roeetal/enph253/Software/Edges/img.jpg

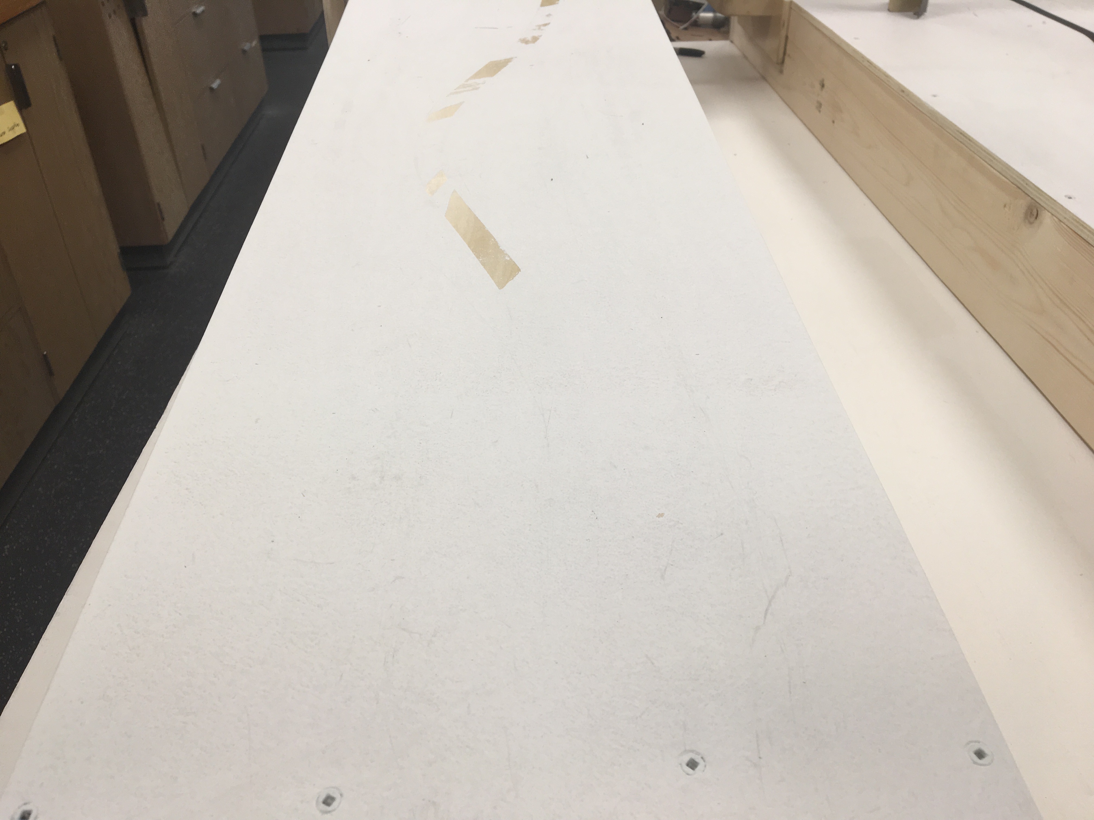
Software/Edges/img.jpg
