roeetal/enph253/Software/STM32/Generic/sonar.JPG

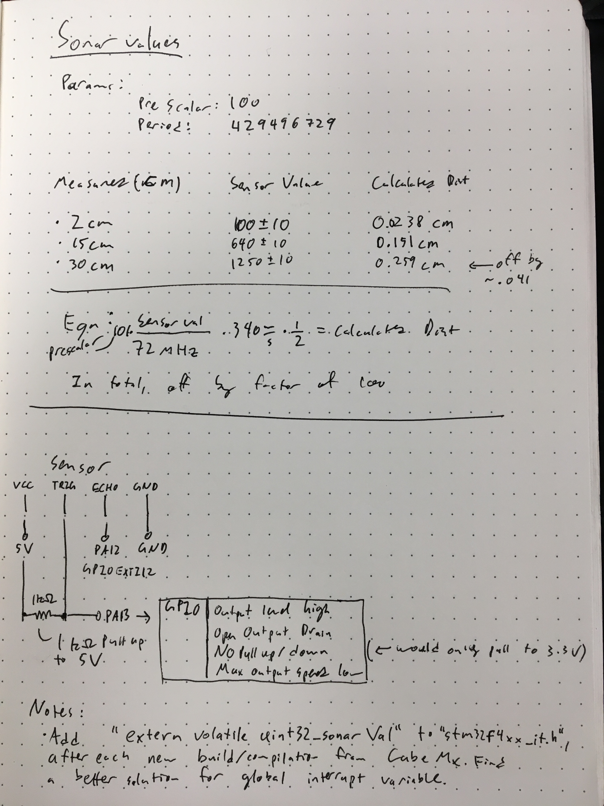
Software/STM32/Generic/sonar.JPG
