roeetal/enph253/README.md

# enph253
## Robot competition

### Links
* Main source-code folder: https://github.com/roeetal/enph253/tree/master/Software/STM32/brain
* Google Slides for technical presentation: 
  https://docs.google.com/presentation/d/15P2V7RuZFssEo_z1w1n5baqb6ON2kBNIlDU9cCNbAWw/edit?usp=sharing
* Report / website:
https://axel-jacobsen.github.io/ENPHRobot/
