roeetal/enph253/Electrical/README.md

# Electrical

## Libraries

Create individual components that you cannot find or import from somewhere else.

## Design Blocks

Multiple compoenents connected together to form a single module, or design block. These get imported into the schematic.
