roeetal/enph253/Presentation/README.md

Software Flowchart Link: https://www.lucidchart.com/documents/edit/5ae4b252-0b9d-4778-aa35-208c34e453aa/0
Major Block Diagram Link: https://www.draw.io

Note: these are both under my account, so this is more for me (axel)
