roeetal/enph253/Software/STM32/adc_dma/Readme.md

https://www.carminenoviello.com/2015/03/02/how-to-use-stm32-nucleo-serial-port/

https://controllerstech.com/adc-using-dma-direct-memory-access/
