roeetal/enph253/Software/STM32/Wiskers/README.md

# Wiskeyyys

- Works well, accurate enough within 22 cm from edge (with a height of 12 cm).
