roeetal/enph253/links.md

## Good Solder Connections
https://www.youtube.com/watch?v=O-ymw7d_nYo

## Cheap Tank Tracks
http://www.instructables.com/id/How-to-make-custom-and-strong-tank-tracks-for-very/
