roeetal/enph253/design_calculations.xlsx

Sheet: Arm
Legend
Good Output
Error Output
Input (Parameters we change)
Calculated Value (Do not touch)
Inputs |  |  | Outputs
Arm Length | 0.2 | m | Can Lift | TRUE
COM | 0.18 | m (from pivot) | FOS | 18.56
Chewie Mass | 0.07 | kg
Mass of Arm | 0.018 | kg
Factor of Safety | 3
Stall torque | 0.32 | N*m

Sheet: DriveTrain
Legend
Good Output
Error Output
Input (Parameters we change)
Calculated Value (Do not touch)
Inputs |  |  | Outputs
Robot Mass | 5.26 | kg | Can Climb Gap | TRUE
Rear Track Length | 0.25 | m | Can Climb Ramp | TRUE
Front Track Length | 0.18 | m
Front Track Rise | 0.076 | m
Gx (measured from rear) | 0.23 | m
Gy (measured from ground) | 0.09 | m
Motor Stall Torque | 0.037 | Nm
Number of motors | 4
Gear Ratio | 25
Factor of Safety | 1
Wheel Radius | 0.0635 | m

Sheet: Basket
Legend
Good Output
Error Output
Input (Parameters we change)
Calculated Value (Do not touch)
Inputs |  |  | Outputs
Arm Length | 0.127 | m | Can Lift | TRUE
Ewok Mass | 0.04 | kg
Chewie Mass | 0.07 | kg
Basket Mass | 0.106 | kg
Servo Stall Torque | 0.4 | Nm
Arm Mass | 0.013 | kg
Factor of Safety | 1.5
