roeetal/enph253/Presentation/b2.png

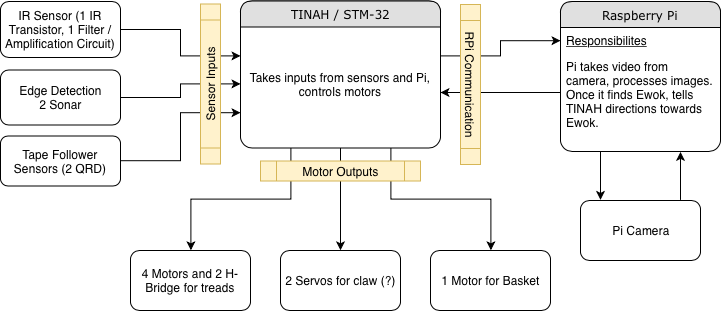
Presentation/b2.png
