roeetal/enph253/Presentation/Software Diagram Transparent Background.png

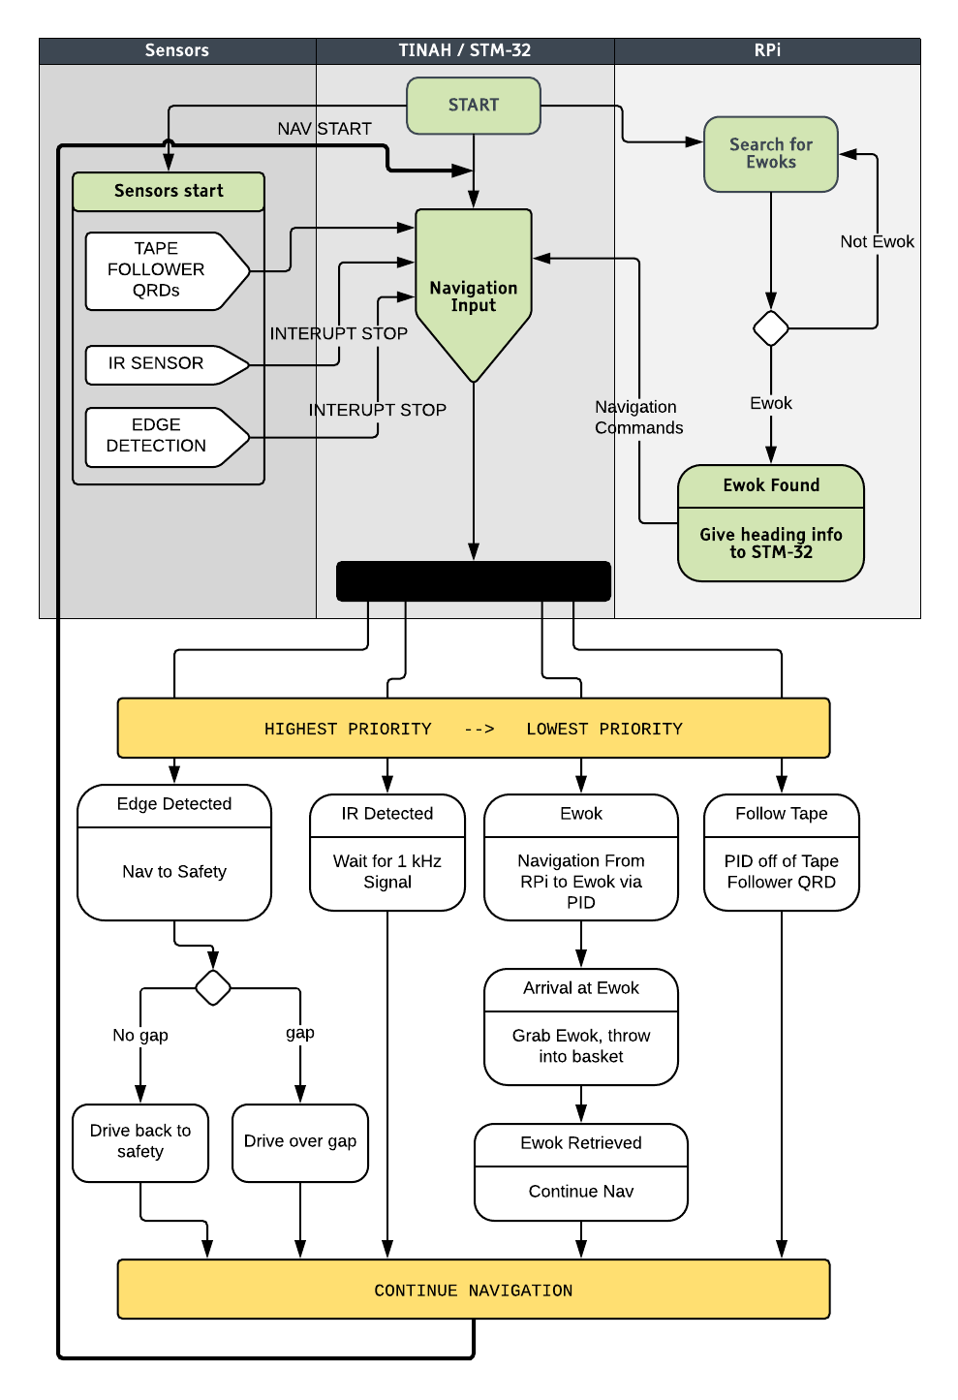
Presentation/Software Diagram Transparent Background.png
