roeetal/enph253/Mechanical/parts.md

# Mechanical Parts

- Chassis
- Arm
- Basket

## Chassis

- Plexiglas or aluminium frame
- Wheels, axles, bearing, motors
- Mounts for other components

## Arm

- Axle, bearings, motor
- Arm frame
- Grabber
- Contact Sensor
- IR sensor

## Basket

- Basket
- Lifting guide/railing
- Motor

## Controls

- TINAH board
- IR sensors
- Sonar Sensors
- Various electronic modules
