roeetal/enph253/Electrical/modules/pcb/board.brd

## EAGLE design Electrical/modules/pcb/board.brd (2018-07-20)

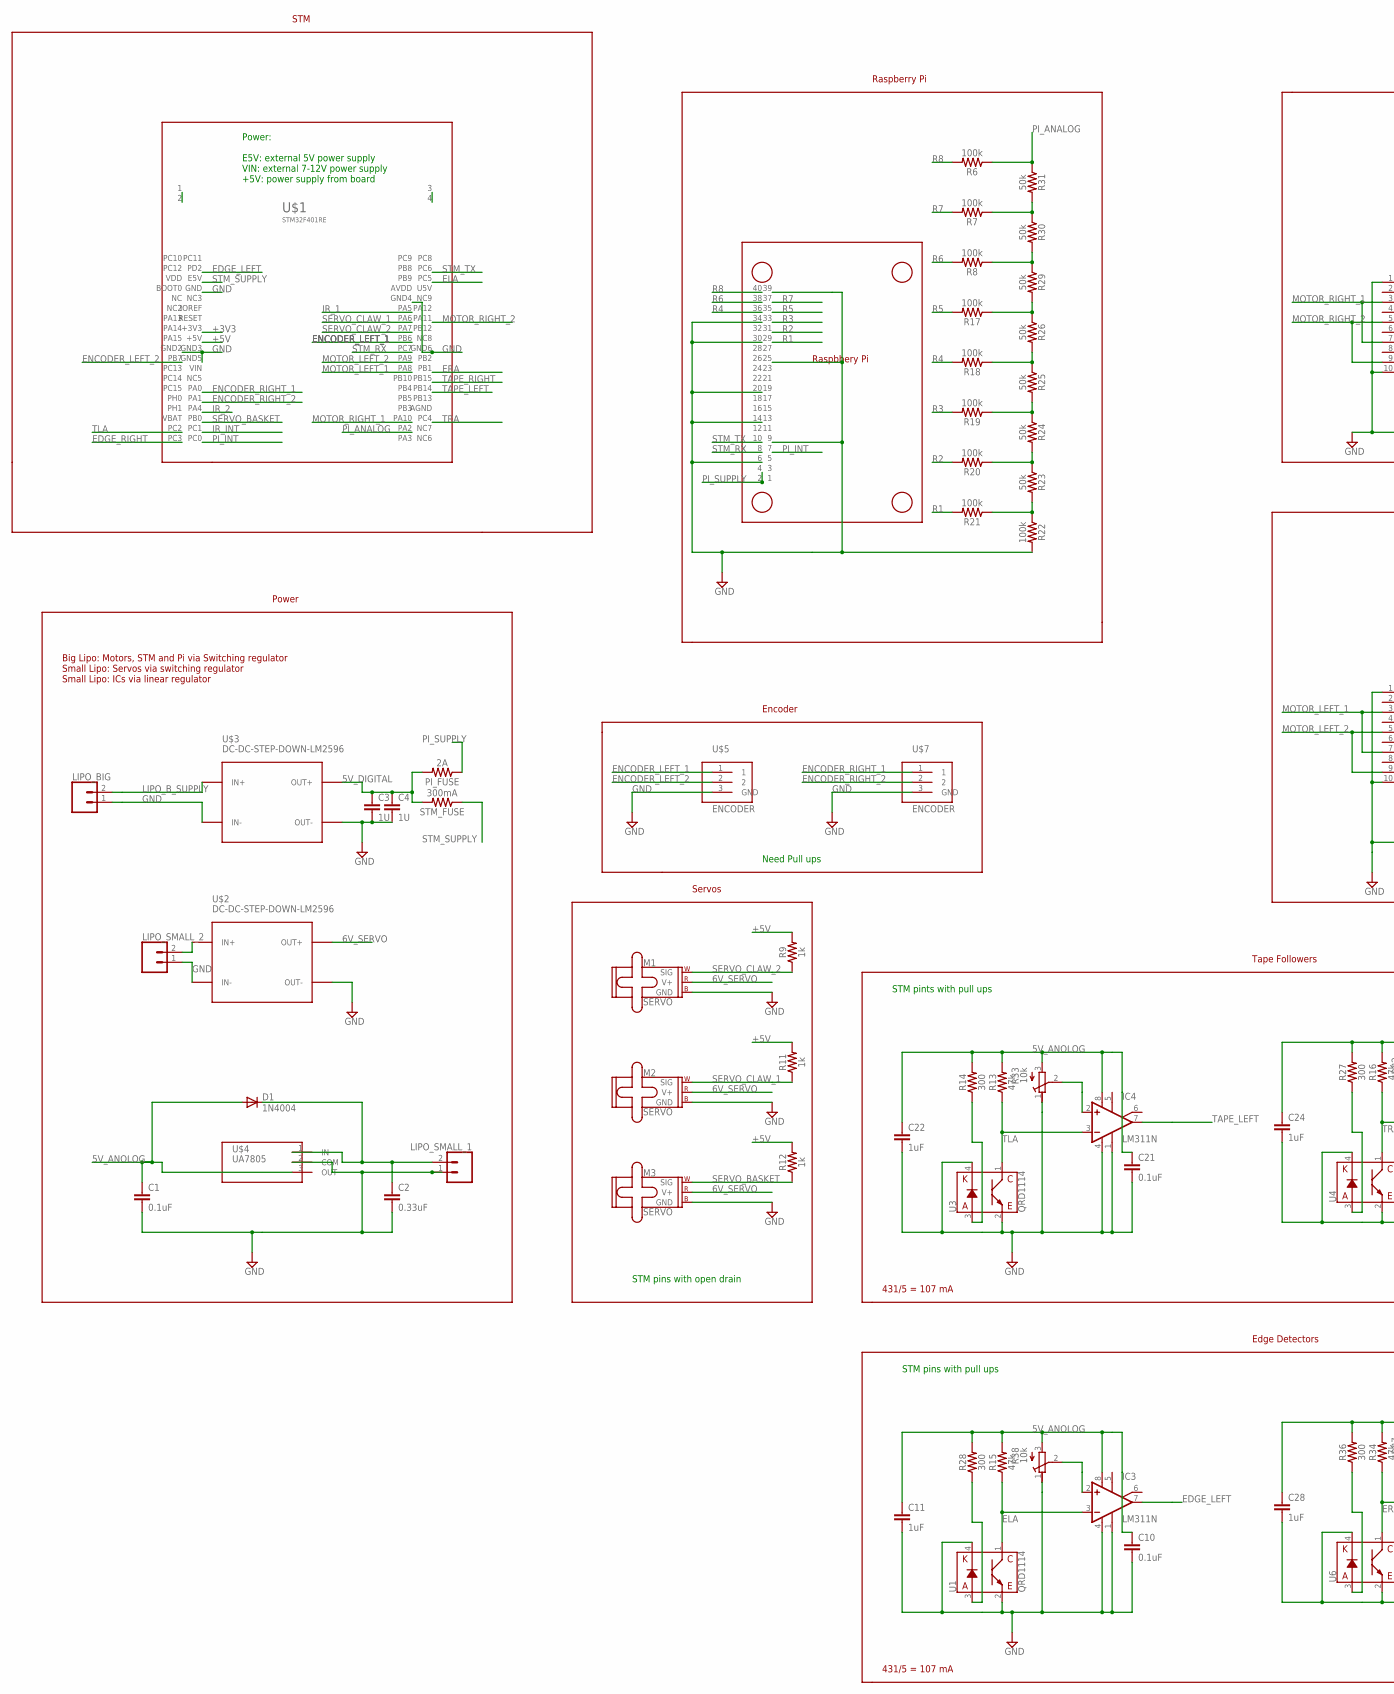
[picture p5: schematic board.sch, part in row 1, column 1]

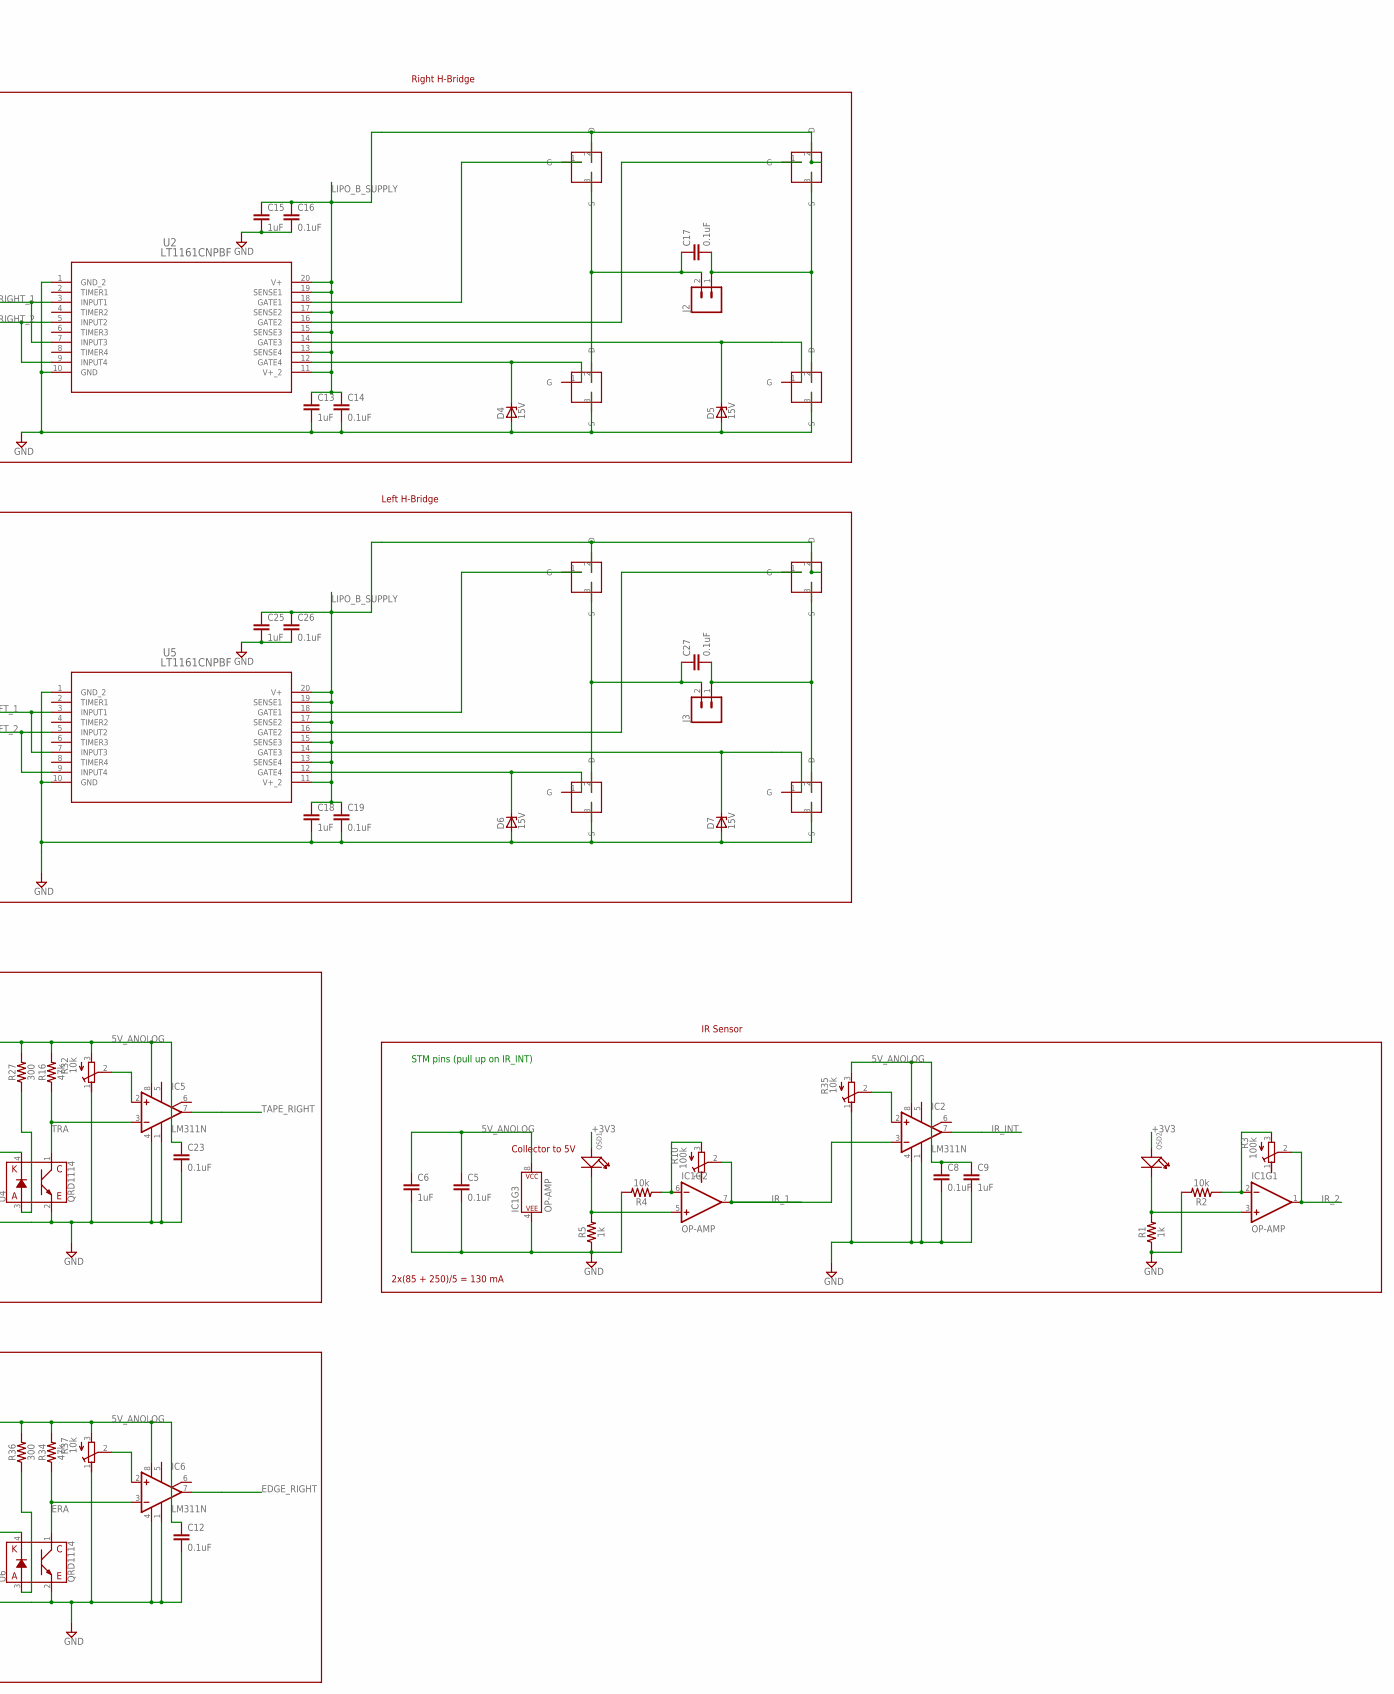
[picture p6: schematic board.sch, part in row 1, column 2]

Parts:
C1, C5, C8, C10, C12, C14, C16, C17, C19, C21, C23, C26, C27: 0.1uF; CAP-PTH-SMALL-KIT
C2: 0.33uF; CAP-PTH-SMALL-KIT
C3, C4: 1U; C5B5
C6, C9, C11, C13, C15, C18, C22, C24, C25, C28: 1uF; CAP-PTH-SMALL-KIT
D1: 1N4004; DO41-10
D4, D5, D6, D7: 15V; DO41Z10
IC1: OP-AMP; DIP08
IC2, IC3, IC4, IC5, IC6: LM311N; DIL08
J2, J3: CONN_02; 1X02
LIPO_BIG: CONN_02; 1X02
LIPO_SMALL_1, LIPO_SMALL_2: CONN_02; 1X02
M1, M2, M3: SERVO; 1X03
PI_FUSE: 2A; AXIAL-0.3
QSD1, QSD2: DIP-LED-GREEN-GREEN(2P-D5MM); LED2-2.54-D5.0MM
R1, R5, R9, R11, R12: 1k; AXIAL-0.3
R2, R4: 10k; AXIAL-0.3
R3, R10: 100k; RTRIMT93YA
R6, R7, R8, R17, R18, R19, R20, R21, R22: 100k; AXIAL-0.3
R13, R15, R16, R34: 47k; AXIAL-0.3
R14, R27, R28, R36: 300; AXIAL-0.3
R23, R24, R25, R26, R29, R30, R31: 50k; AXIAL-0.3
R32, R33, R35, R37, R38: 10k; RTRIMT93YA
STM_FUSE: 300mA; AXIAL-0.3
U1, U3, U4, U6: QRD1114
U2, U5: LT1161CNPBF; PDIP-20_N
U$1: STM32F401RE; STM32
U$2, U$3: DC-DC-STEP-DOWN-LM2596
U$4: UA7805; TO-220AB
U$5, U$7: ENCODER; TO-220AB
U$6: RPI3; PI
U$11, U$12, U$13, U$14, U$15, U$16, U$17, U$18: HUF75321; TO-220AB

Connections:
5V_ANOLOG: C1.1, C5.1, C6.1, C8.1, C9.1, C10.1, C11.1, C12.1, C21.1, C22.1, C23.1, C24.1, C28.1, D1.A, IC1.8 (P$V+), IC2.8 (V+), IC3.8 (V+), IC4.8 (V+), IC5.8 (V+), IC6.8 (V+), R13.P$2 (2), R14.P$2 (2), R15.P$2 (2), R16.P$2 (2), R27.P$2 (2), R28.P$2 (2), R32.3 (A), R33.3 (A), R34.P$2 (2), R35.3 (A), R36.P$2 (2), R37.3 (A), R38.3 (A), U$4.3 (OUT)
5V_DIGITAL: C3.1, C4.1, PI_FUSE.P$2 (2), STM_FUSE.P$2 (2), U$3.OUT+
6V_SERVO: M1.2 (V+), M2.2 (V+), M3.2 (V+), U$2.OUT+
+3V3: QSD1.+, QSD2.+, U$1.+3V3
+5V: R9.P$2 (2), R11.P$2 (2), R12.P$2 (2), U$1.+5V
EDGE_LEFT: IC3.7 (OUT), U$1.PD2
EDGE_RIGHT: IC6.7 (OUT), U$1.PC3
ELA: IC3.3 (-IN), R15.P$1 (1), U1.1 (C), U$1.PC5
ENCODER_LEFT_1: U$1.PB6, U$5.1
ENCODER_LEFT_2: U$1.PB7, U$5.2
ENCODER_RIGHT_1: U$1.PA0, U$7.1
ENCODER_RIGHT_2: U$1.PA1, U$7.2
ERA: IC6.3 (-IN), R34.P$1 (1), U6.1 (C), U$1.PB1
GND: C1.2, C2.2, C3.2, C4.2, C5.2, C6.2, C8.2, C9.2, C10.2, C11.2, C12.2, C13.2, C14.2, C15.2, C16.2, C18.2, C19.2, C21.2, C22.2, C23.2, C24.2, C25.2, C26.2, C28.2, D4.A, D5.A, D6.A, D7.A, IC1.4 (P$V-), IC2.1 (GND), IC2.4 (V-), IC3.1 (GND), IC3.4 (V-), IC4.1 (GND), IC4.4 (V-), IC5.1 (GND), IC5.4 (V-), IC6.1 (GND), IC6.4 (V-), LIPO_BIG.1, LIPO_SMALL_1.1, LIPO_SMALL_2.1, M1.3 (GND), M2.3 (GND), M3.3 (GND), R1.P$1 (1), R2.P$2 (2), R4.P$2 (2), R5.P$1 (1), R22.P$2 (2), R32.1 (E), R33.1 (E), R35.1 (E), R37.1 (E), R38.1 (E), U1.2 (E), U1.4 (K), U2.1 (GND_2), U2.10 (GND), U3.2 (E), U3.4 (K), U4.2 (E), U4.4 (K), U5.1 (GND_2), U5.10 (GND), U6.2 (E), U6.4 (K), U$1.GND, U$1.GND2, U$1.GND3, U$1.GND4, U$1.GND5, U$1.GND6, U$2.IN-, U$2.OUT-, U$3.IN-, U$3.OUT-, U$4.2 (COM), U$5.3 (GND), U$6.6, U$6.9, U$6.14, U$6.20, U$6.25, U$6.30, U$6.34, U$6.39, U$7.3 (GND), U$13.3 (S), U$14.3 (S), U$17.3 (S), U$18.3 (S)
IR_1: IC1.7 (OUT), IC2.3 (-IN), R10.2 (S), U$1.PA5
IR_2: IC1.1 (OUT), R3.2 (S), U$1.PA4
IR_INT: IC2.7 (OUT), U$1.PC1
LIPO_B_SUPPLY: C13.1, C14.1, C15.1, C16.1, C18.1, C19.1, C25.1, C26.1, LIPO_BIG.2, U2.11 (V+_2), U2.13 (SENSE4), U2.15 (SENSE3), U2.17 (SENSE2), U2.19 (SENSE1), U2.20 (V+), U5.11 (V+_2), U5.13 (SENSE4), U5.15 (SENSE3), U5.17 (SENSE2), U5.19 (SENSE1), U5.20 (V+), U$3.IN+, U$11.2 (D), U$12.2 (D), U$15.2 (D), U$16.2 (D)
MOTOR_LEFT_1: U5.3 (INPUT1), U5.7 (INPUT3), U$1.PA8
MOTOR_LEFT_2: U5.5 (INPUT2), U5.9 (INPUT4), U$1.PA9
MOTOR_RIGHT_1: U2.3 (INPUT1), U2.7 (INPUT3), U$1.PA10
MOTOR_RIGHT_2: U2.5 (INPUT2), U2.9 (INPUT4), U$1.PA11
unnamed: LIPO_SMALL_2.2, U$2.IN+
unnamed: IC1.2 (-IN), R2.P$1 (1), R3.3 (A)
unnamed: R28.P$1 (1), U1.3 (A)
unnamed: IC1.6 (-IN), R4.P$1 (1), R10.3 (A)
unnamed: R21.P$1 (1), R22.P$1 (1), R23.P$2 (2)
unnamed: IC5.2 (+IN), R32.2 (S)
unnamed: R20.P$1 (1), R23.P$1 (1), R24.P$2 (2)
unnamed: R19.P$1 (1), R24.P$1 (1), R25.P$2 (2)
unnamed: R18.P$1 (1), R25.P$1 (1), R26.P$2 (2)
unnamed: R17.P$1 (1), R26.P$1 (1), R29.P$2 (2)
unnamed: R8.P$1 (1), R29.P$1 (1), R30.P$2 (2)
unnamed: R7.P$1 (1), R30.P$1 (1), R31.P$2 (2)
unnamed: IC2.2 (+IN), R35.2 (S)
unnamed: IC3.2 (+IN), R38.2 (S)
unnamed: R14.P$1 (1), U3.3 (A)
unnamed: R36.P$1 (1), U6.3 (A)
unnamed: IC6.2 (+IN), R37.2 (S)
unnamed: U2.18 (GATE1), U$11.1 (G)
unnamed: U2.16 (GATE2), U$12.1 (G)
unnamed: D5.C, U2.14 (GATE3), U$14.1 (G)
unnamed: D4.C, U2.12 (GATE4), U$13.1 (G)
unnamed: C17.2, J2.1, U$12.3 (S), U$14.2 (D)
unnamed: C17.1, J2.2, U$11.3 (S), U$13.2 (D)
unnamed: U5.18 (GATE1), U$15.1 (G)
unnamed: U5.16 (GATE2), U$16.1 (G)
unnamed: IC4.2 (+IN), R33.2 (S)
unnamed: R27.P$1 (1), U4.3 (A)
unnamed: U$1.1, U$1.2
unnamed: D7.C, U5.14 (GATE3), U$18.1 (G)
unnamed: D6.C, U5.12 (GATE4), U$17.1 (G)
unnamed: C27.2, J3.1, U$16.3 (S), U$18.2 (D)
unnamed: C27.1, J3.2, U$15.3 (S), U$17.2 (D)
unnamed: U$1.3, U$1.4
OUTPUT1: IC1.5 (+IN), QSD1.-, R5.P$2 (2)
OUTPUT2: IC1.3 (+IN), QSD2.-, R1.P$2 (2)
PI_ANALOG: R6.P$1 (1), R31.P$1 (1), U$1.PA2
PI_INT: U$1.PC0, U$6.7
PI_SUPPLY: PI_FUSE.P$1 (1), U$6.2, U$6.4
R1: R21.P$2 (2), U$6.29
R2: R20.P$2 (2), U$6.31
R3: R19.P$2 (2), U$6.33
R4: R18.P$2 (2), U$6.36
R5: R17.P$2 (2), U$6.35
R6: R8.P$2 (2), U$6.38
R7: R7.P$2 (2), U$6.37
R8: R6.P$2 (2), U$6.40
SERVO_BASKET: M3.1 (SIG), R12.P$1 (1), U$1.PB0
SERVO_CLAW_1: M2.1 (SIG), R11.P$1 (1), U$1.PA6
SERVO_CLAW_2: M1.1 (SIG), R9.P$1 (1), U$1.PA7
STM_RX: U$1.PC7, U$6.8
STM_SUPPLY: STM_FUSE.P$1 (1), U$1.E5V
STM_TX: U$1.PC6, U$6.10
TAPE_LEFT: IC4.7 (OUT), U$1.PB14
TAPE_RIGHT: IC5.7 (OUT), U$1.PB15
TLA: IC4.3 (-IN), R13.P$1 (1), U3.1 (C), U$1.PC2
TRA: IC5.3 (-IN), R16.P$1 (1), U4.1 (C), U$1.PC4
V_IN1: C2.1, D1.C, LIPO_SMALL_1.2, U$4.1 (IN)

Notes on the sheet:
Power: E5V: external 5V power supply VIN: external 7-12V power supply +5V: power supply from board
Collector to 5V
STM pins (pull up on IR_INT)
STM pints with pull ups
Tape Followers
IR Sensor
2x(85 + 250)/5 = 130 mA
431/5 = 107 mA
Big Lipo: Motors, STM and Pi via Switching regulator Small Lipo: Servos via switching regulator Small Lipo: ICs via linear regulator
Power
STM
Servos
STM pins with open drain
Left H-Bridge
Right H-Bridge
Encoder
Raspberry Pi
STM pins with pull ups
Edge Detectors
Need Pull ups

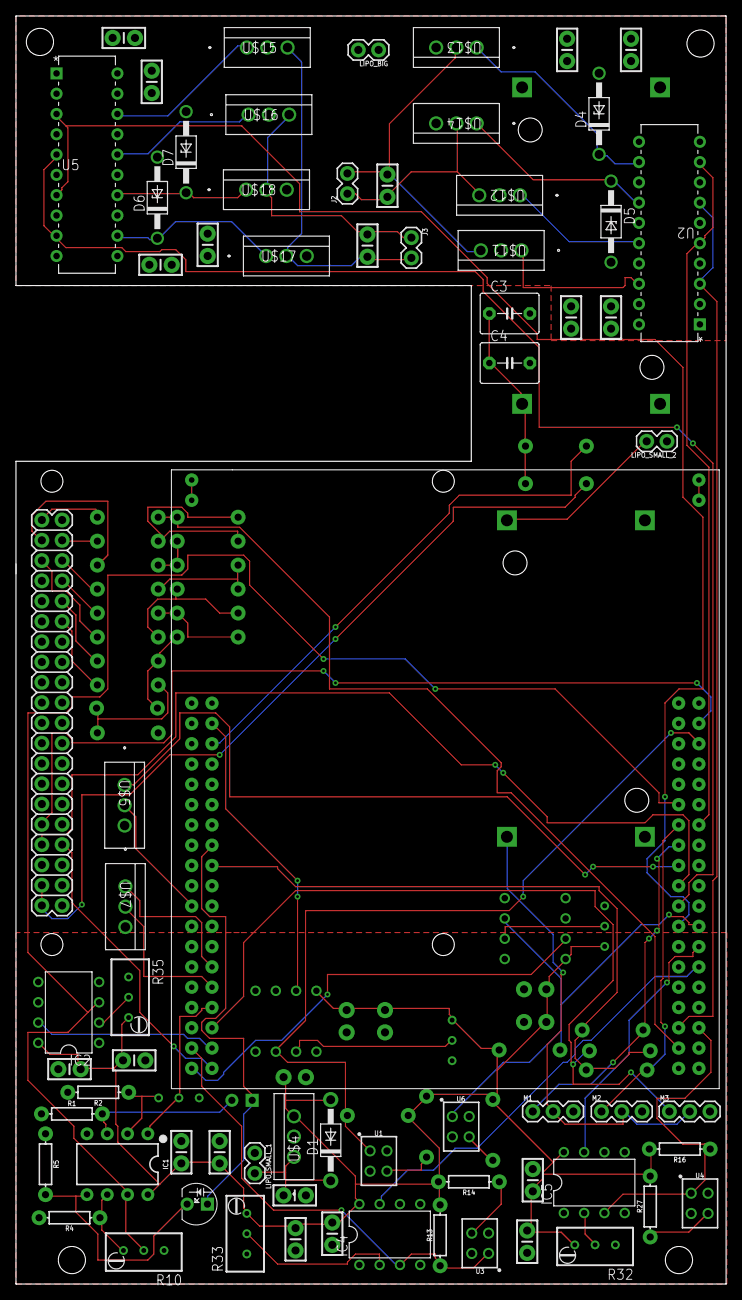
[picture p7: board board.brd from above]

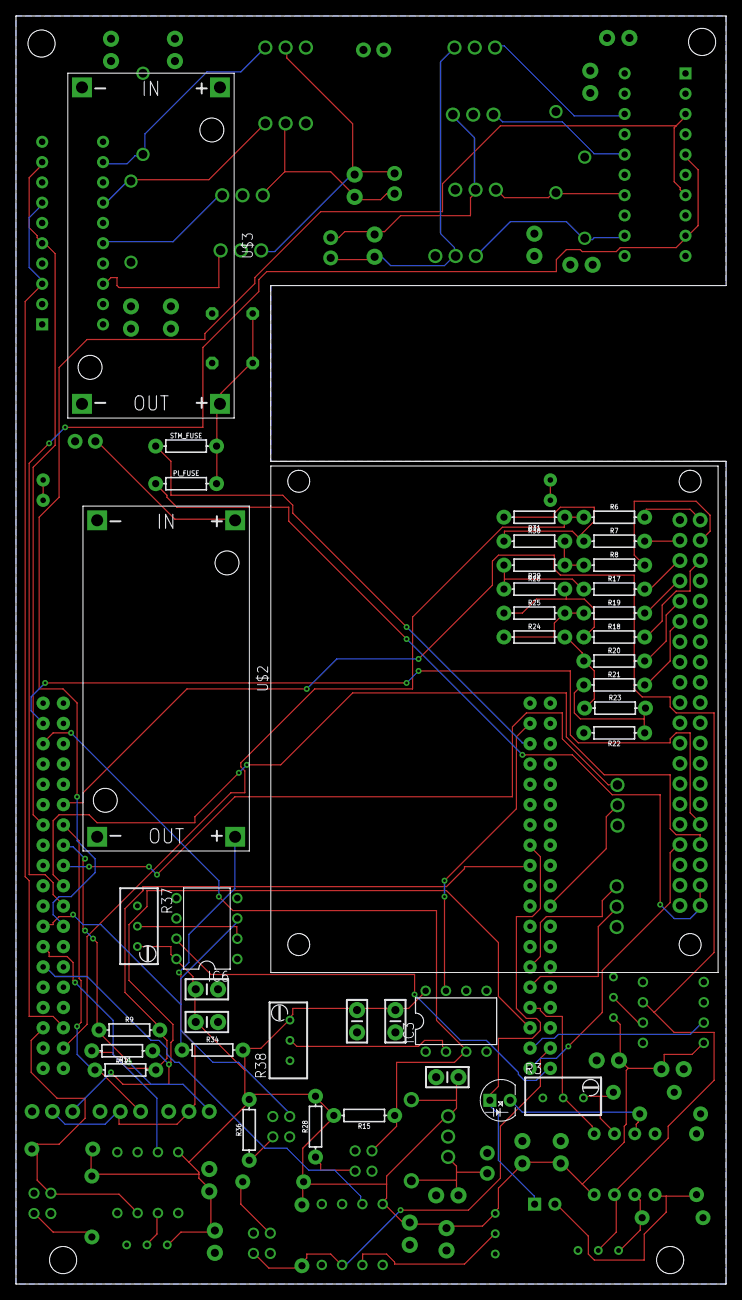
[picture p8: board board.brd from below]

Board: 2 copper layers, 88.9 x 158.8 mm, 108 parts (38 on the bottom side), 79 nets.
