roeetal/enph253/Software/STM32/thikc/Src/main.c

/**
 ******************************************************************************
 * @file           : main.c
 * @brief          : Main program body
 ******************************************************************************
 ** This notice applies to any and all portions of this file
 * that are not between comment pairs USER CODE BEGIN and
 * USER CODE END. Other portions of this file, whether 
 * inserted by the user or by software development tools
 * are owned by their respective copyright owners.
 *
 * COPYRIGHT(c) 2018 STMicroelectronics
 *
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
 ******************************************************************************
 */
/* Includes ------------------------------------------------------------------*/
#include "main.h"
#include "stm32f1xx_hal.h"
#include "adc.h"
#include "dma.h"
#include "i2c.h"
#include "tim.h"
#include "usart.h"
#include "gpio.h"

/* USER CODE BEGIN Includes */
#include "fonts.h"
#include "ssd1306.h"
#include "encoder.h"
#include "pid.h"
#include "filter.h"
#include "extern_vars.h"
#include <String.h>
#include "claw.h"

/* USER CODE END Includes */


/* USER CODE BEGIN PV */
uint16_t LEFT_SPEED = 40000;
uint16_t RIGHT_SPEED = 45000;
uint32_t dma_buffer[2048];
uint32_t ir_values[2048];
/* USER CODE END PV */

void SystemClock_Config(void);

/* USER CODE BEGIN PFP */
void print(char msg[], int row);
void do_pid(PID_t *pid_struct);
PID_t menu();
void frequency_comparison(uint16_t freq1, uint16_t freq2, uint16_t GPIO_Pin);
void pi_navigation();
float calculate_heading(uint32_t adc_val);
void encoder_pid(PID_t *left_pid, ENCODER_t *left_enc, PID_t *right_pid, ENCODER_t *right_enc);
void set_motor_speed(uint32_t channel, uint32_t speed);
void turn();
void turn_deg(uint8_t);
void alarm_detect();

/* USER CODE END PFP */

/* USER CODE BEGIN 0 */
/**
 * @brief Circu;ar DMA buffer loading on each full buffer
 * DMA uses dma_buffer, transfers data to ir_values for us to use
 * Order of buffer: ir1, ir2, ir1, ir2...
 */
void HAL_ADC_ConvCpltCallback(ADC_HandleTypeDef *hadc)
{
    memcpy(ir_values, dma_buffer, sizeof(dma_buffer));
}

/* USER CODE END 0 */

/**
 * @brief  The application entry point.
 *
 * @retval None
 */
int main(void)
{
    /* MCU Configuration----------------------------------------------------------*/

    /* Reset of all peripherals, Initializes the Flash interface and the Systick. */
    HAL_Init();

    /* Configure the system clock */
    SystemClock_Config();

    /* Initialize all configured peripherals */
    MX_GPIO_Init();
    MX_DMA_Init();
    MX_TIM4_Init();
    MX_TIM3_Init();
    MX_TIM1_Init();
    MX_ADC1_Init();
    MX_TIM2_Init();
    MX_USART2_UART_Init();
    MX_ADC2_Init();
    MX_I2C1_Init();
    /* USER CODE BEGIN 2 */

    /* Initialize peripherals */
    HAL_TIM_Encoder_Start(&htim3, TIM_CHANNEL_ALL);
    HAL_TIM_Encoder_Start(&htim4, TIM_CHANNEL_ALL);
    HAL_TIM_PWM_Start(&htim1, TIM_CHANNEL_1);
    HAL_TIM_PWM_Start(&htim1, TIM_CHANNEL_2);
    HAL_TIM_PWM_Start(&htim1, TIM_CHANNEL_3);
    HAL_TIM_PWM_Start(&htim1, TIM_CHANNEL_4);
    HAL_TIM_PWM_Start(&htim2, TIM_CHANNEL_1);
    HAL_TIM_PWM_Start(&htim2, TIM_CHANNEL_2);
    HAL_TIM_PWM_Start(&htim2, TIM_CHANNEL_3);
    ssd1306_Init();
    print("Starting...", 0);
    claw_init(&htim2);

    /* Initialize other stuffs*/
    // 3 * gain * kp = 20,000
    ENCODER_t left_enc = encoder_Init(TIM3);
    ENCODER_t right_enc = encoder_Init(TIM4);
    PID_t left_pid = pid_Init(1000, 250, 0, 2, 2);
    PID_t right_pid = pid_Init(6000, 500, 0, 2, 2);
    uint8_t ewok_cnt = 0;
    //PID_t pid_struct = menu();
    /* USER CODE END 2 */

    /* Infinite loop */
    /* USER CODE BEGIN WHILE */
    set_motor_speed(TIM_CHANNEL_1, LEFT_SPEED);
    set_motor_speed(TIM_CHANNEL_3, RIGHT_SPEED);
    HAL_Delay(5000);
    set_motor_speed(TIM_CHANNEL_1, 0);
    set_motor_speed(TIM_CHANNEL_3, 0);
    HAL_Delay(1000);
    CLAW_INT_STATE = NOT_FLAGGED;
    PI_INT_STATE = NOT_FLAGGED;
    while (1)
    {
        // // encoder_pid(&left_pid, &left_enc, &right_pid, &right_enc);
        print("in whiel", 0);
        // set_motor_speed(TIM_CHANNEL_1, LEFT_SPEED);
        // set_motor_speed(TIM_CHANNEL_3, RIGHT_SPEED);
        // if (CLAW_INT_STATE == FLAGGED)
        // {
        //     print("CLAW INT", 0);
        //     set_motor_speed(TIM_CHANNEL_1, 0);
        //     set_motor_speed(TIM_CHANNEL_3, 0);
        //     actuatengo(&htim2, TIM_CHANNEL_2, TIM_CHANNEL_3);
        //     HAL_Delay(1000);
        //     CLAW_INT_STATE = NOT_FLAGGED;
        // }
        if (PI_INT_STATE == FLAGGED)
        {
            print("in pi int", 0);
            turn();

            set_motor_speed(TIM_CHANNEL_1, LEFT_SPEED);
            set_motor_speed(TIM_CHANNEL_3, RIGHT_SPEED);
            int start = HAL_GetTick();
            while (HAL_GetTick() - start < 4000)
            {
                // encoder_dist_pid(&left_pid);
                if (CLAW_INT_STATE == FLAGGED)
                {
                    HAL_Delay(200);
                    set_motor_speed(TIM_CHANNEL_1, 0);
                    set_motor_speed(TIM_CHANNEL_3, 0);
                    actuatengo(&htim2, TIM_CHANNEL_2, TIM_CHANNEL_3);
                    CLAW_INT_STATE = NOT_FLAGGED;
                    ++ewok_cnt;
                    char msg[18] = "";
                    sprintf(msg, "wok_cnt: %d", ewok_cnt);
                    print(msg, 0);
                    if (ewok_cnt == 1)
                    {
                        turn_deg(-120);
                        arm_up_to_deg(&htim2, 80);
                        set_motor_speed(TIM_CHANNEL_1, LEFT_SPEED);
                        set_motor_speed(TIM_CHANNEL_3, RIGHT_SPEED);
                        HAL_Delay(3000);
                        CLAW_INT_STATE = NOT_FLAGGED;
                    }
                    break;
                }
            }
            // char pic_plz = "1";
            // HAL_UART_Transmit(&huart2, pic_plz, sizeof(pic_plz), 10000);
            PI_INT_STATE = NOT_FLAGGED;
            set_motor_speed(TIM_CHANNEL_1, 0);
            set_motor_speed(TIM_CHANNEL_3, 0);
        }
        // if (IR_INT_STATE == FLAGGED)
        // {
        //     alarm_detect();
        // }
        /* USER CODE END WHILE */

        /* USER CODE BEGIN 3 */
    }
    /* USER CODE END 3 */
}

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
/* USER CODE BEGIN 4 */

/*
 * Assume motors are not on.
 * Reads adc, turns left or right based on voltage. Left max= 0 , no turn = 1.65 V, right max = 3.3V.
 */
void turn()
{
    HAL_ADC_Start(&hadc2);
    if (HAL_ADC_PollForConversion(&hadc2, 100) == HAL_OK)
    {
        float volts = calculate_heading(HAL_ADC_GetValue(&hadc2));
        uint16_t counts = TURN_CONST * fabs(volts);
        TIM3->CNT = 0;
        TIM4->CNT = 0;

        char msg[18] = "";
        sprintf(msg, "cnts: %d", counts);
        print(msg, 0);
        int pre_dec = (int)(volts / 1);
        int post_dec = (int)((volts - pre_dec) * 1000);
        sprintf(msg, "vlts: %d.%d", pre_dec, post_dec);
        print(msg, 2);

        if (volts < -TURN_TOLERANCE)  // FIXME: Ben changed this
        {
            set_motor_speed(TIM_CHANNEL_1, 0);
            set_motor_speed(TIM_CHANNEL_3, RIGHT_SPEED);
            while (TIM4->CNT < counts)
            {
                sprintf(msg, "TIM4->CNT: %d", TIM4->CNT);
                print(msg, 4);
            }
            sprintf(msg, "TIM4->CNT: %d", TIM4->CNT);
            print(msg, 4);
            TIM4->CNT = 0;
        }
        else if (volts > TURN_TOLERANCE) // FIXME: Ben changed this
        {
            set_motor_speed(TIM_CHANNEL_1, LEFT_SPEED);
            set_motor_speed(TIM_CHANNEL_3, 0);
            while (TIM3->CNT < counts)
            {
                sprintf(msg, "TIM3->CNT: %d", TIM3->CNT);
                print(msg, 4);
            }
            sprintf(msg, "TIM3->CNT: %d", TIM3->CNT);
            print(msg, 4);
            TIM3->CNT = 0;
        }
        set_motor_speed(TIM_CHANNEL_1, 0);
        set_motor_speed(TIM_CHANNEL_3, 0);
    }
    else
    {
        print("Shits fucked yo", 0);
    }
    HAL_ADC_Stop(&hadc2);
}

/*
 * Assume motors are not on.
 * Reads adc, turns left or right based on voltage. Left max= 0 , no turn = 1.65 V, right max = 3.3V.
 */
void turn_deg(uint8_t deg)
{
    HAL_ADC_Start(&hadc2);
    if (HAL_ADC_PollForConversion(&hadc2, 100) == HAL_OK)
    {
        uint16_t counts = 50.0 / 90.0 * (deg-90) + 50;
        TIM3->CNT = 0;
        TIM4->CNT = 0;

        char msg[18] = "";

        if (deg > 0) // FIXME: Ben changed this
        {
            set_motor_speed(TIM_CHANNEL_1, 0);
            set_motor_speed(TIM_CHANNEL_3, 30000);
            while (TIM4->CNT < counts)
            {
                sprintf(msg, "TIM4->CNT: %d", TIM4->CNT);
                print(msg, 4);
            }
            sprintf(msg, "TIM4->CNT: %d", TIM4->CNT);
            print(msg, 4);
            TIM4->CNT = 0;
        }
        else if (deg < 0) // FIXME: Ben changed this
        {
            set_motor_speed(TIM_CHANNEL_1, 30000);
            set_motor_speed(TIM_CHANNEL_3, 0);
            while (TIM3->CNT < counts)
            {
                sprintf(msg, "TIM3->CNT: %d", TIM3->CNT);
                print(msg, 4);
            }
            sprintf(msg, "TIM3->CNT: %d", TIM3->CNT);
            print(msg, 4);
            TIM3->CNT = 0;
        }
        set_motor_speed(TIM_CHANNEL_1, 0);
        set_motor_speed(TIM_CHANNEL_3, 0);
    }
    else
    {
        print("Shits fucked yo", 0);
    }
    HAL_ADC_Stop(&hadc2);
}

void pi_navigation()
{
    HAL_ADC_Start(&hadc2);
    print("Pi nav", 0);
    if (HAL_ADC_PollForConversion(&hadc2, 1000000) == HAL_OK)
    {
        float heading = calculate_heading(HAL_ADC_GetValue(&hadc2));
        if (heading < 0)
        {
            set_motor_speed(TIM_CHANNEL_2, 10000);
            set_motor_speed(TIM_CHANNEL_3, 10000);
            heading *= -1;
        }
        else if (heading > 0)
        {
            set_motor_speed(TIM_CHANNEL_1, 10000);
            set_motor_speed(TIM_CHANNEL_4, 10000);
        }
        HAL_Delay(2000 * heading);
        set_motor_speed(TIM_CHANNEL_1, 20000);
        set_motor_speed(TIM_CHANNEL_3, 20000);
    }
    else
    {
        print("No adc", 0);
    }
    HAL_ADC_Stop(&hadc2);
    PI_INT_STATE = NOT_FLAGGED;
}

/**
 * Resistor ladder: 8-bit, 0->3.3v.
 * ADC: 12-bit, 0->3.3V
 *
 * @param adc_val, value read from ADC.
 * @return heading as a percentage from -50 (left) to 50 (right).
 **/
float calculate_heading(uint32_t adc_val)
{
    return adc_val / 4096.0 - 0.5;
}

void alarm_detect()
{
    HAL_ADC_Start_DMA(&hadc1, dma_buffer, sizeof(dma_buffer) / sizeof(dma_buffer[0]));
    //TODO calculate time needed to fill first buffer
    HAL_Delay(500);
    while (1)
    {
        char msg[18] = "";
        // Sampling frequency: 10.6667e6/(2*(239.5+15))
        // freq one
        double val = goertzel(ir_values, 20956, 10000, sizeof(dma_buffer) / sizeof(dma_buffer[0]), 0);
        int predec = (int)(val / 1);
        int postdec = (int)((val - predec) * 1000);
        sprintf(msg, "%d.%d\n", predec, postdec);
        print(msg, 0);
        //compare
        if (val > 10)
        {
            break;
        }
    }
    print("Go", 0);
    HAL_ADC_Stop_DMA(&hadc1);
    IR_INT_STATE = NOT_FLAGGED;
}

void frequency_comparison(uint16_t freq1, uint16_t freq2, uint16_t GPIO_Pin)
{
    uint16_t offset = GPIO_Pin == IR_1_Pin ? 0 : GPIO_Pin == IR_2_Pin ? 1 : 2;
    HAL_ADC_Start_DMA(&hadc1, dma_buffer, sizeof(dma_buffer) / sizeof(dma_buffer[0]));
    //TODO calculate time needed to fill first buffer
    HAL_Delay(500);
    //TODO figure out thresholds and what we want to look for
    while (1)
    {
        char msg[18] = "";
        // Sampling frequency: 10.6667e6/(2*(239.5+15))
        // freq one
        double val1 = goertzel(ir_values, 20956, freq1, sizeof(dma_buffer) / sizeof(dma_buffer[0]), offset);
        int predec = (int)(val1 / 1);
        int postdec = (int)((val1 - predec) * 1000);
        sprintf(msg, "%d.%d\n", predec, postdec);
        print(msg, 0);
        HAL_UART_Transmit(&huart2, (uint8_t *)msg, strlen(msg), 0xFFFF);
        //freq2
        double val2 = goertzel(ir_values, 20956, freq2, sizeof(dma_buffer) / sizeof(dma_buffer[0]), offset);
        predec = (int)(val2 / 1);
        postdec = (int)((val2 - predec) * 1000);
        sprintf(msg, "%d.%d", predec, postdec);
        HAL_UART_Transmit(&huart2, (uint8_t *)msg, strlen(msg), 0xFFFF);
        //compare
        if (val1 > val2)
        {
            break;
        }
    }
    HAL_ADC_Stop_DMA(&hadc1);
    IR_INT_STATE = NOT_FLAGGED;
}

/**
 * @brief prints string to row, rows from 0 - 6, resets screen when printing from row 0
 * @param msg, string to print
 * @param row, row to print msg to
 */
void print(char *msg, int row)
{
    if (row == 0)
    {
        ssd1306_Fill(Black);
    }
    ssd1306_SetCursor(0, row * 10);
    ssd1306_WriteString(msg, Font_7x10, White);
    ssd1306_UpdateScreen();
}

PID_t menu()
{
    print("Starting", 0);
    char msg[20] = "";
    int pid_select = 0;
    uint32_t values[3] = {0, 0, 0};
    while (1)
    {
        if (HAL_GPIO_ReadPin(MENU_GPIO_Port, MENU_Pin) == 0)
        {
            sprintf(msg, "%lu", values[pid_select]);
            print(msg, 0);
            TIM4->CNT = values[pid_select];
            while (HAL_GPIO_ReadPin(MENU_GPIO_Port, MENU_Pin) == 0)
            {
                values[pid_select] = TIM4->CNT;
                sprintf(msg, "%lu", values[pid_select]);
                print(msg, 0);
            }
            ++pid_select;
        }
        if (pid_select == 3)
            break;
    }
    while (1)
    {
        int speed = 20000;
        if (HAL_GPIO_ReadPin(MENU_GPIO_Port, MENU_Pin) == 0)
        {
            if (pid_select == 3)
            {
                HAL_TIM_PWM_Start(&htim1, TIM_CHANNEL_1);
                HAL_TIM_PWM_Stop(&htim1, TIM_CHANNEL_3);
            }
            else
            {
                HAL_TIM_PWM_Stop(&htim1, TIM_CHANNEL_1);
                HAL_TIM_PWM_Start(&htim1, TIM_CHANNEL_3);
            }
            sprintf(msg, "%d", speed);
            print(msg, 0);
            TIM4->CNT = speed;
            while (HAL_GPIO_ReadPin(MENU_GPIO_Port, MENU_Pin) == 0)
            {
                speed = TIM4->CNT;
                sprintf(msg, "%d", speed);
                print(msg, 0);
                if (pid_select == 3)
                {
                    __HAL_TIM_SET_COMPARE(&htim1, TIM_CHANNEL_1, speed);
                    LEFT_SPEED = speed;
                }
                else
                {
                    __HAL_TIM_SET_COMPARE(&htim1, TIM_CHANNEL_3, speed);
                    RIGHT_SPEED = speed;
                }
            }
            ++pid_select;
        }
        if (pid_select == 5)
        {
            break;
        }
    }
    HAL_TIM_PWM_Stop(&htim1, TIM_CHANNEL_1);
    HAL_TIM_PWM_Stop(&htim1, TIM_CHANNEL_3);
    sprintf(msg, "P %lu", values[0]);
    print(msg, 0);
    sprintf(msg, "D %lu", values[1]);
    print(msg, 1);
    sprintf(msg, "I %lu", values[2]);
    print(msg, 2);
    sprintf(msg, "L %u", LEFT_SPEED);
    print(msg, 3);
    sprintf(msg, "R %u", RIGHT_SPEED);
    print(msg, 4);
    HAL_Delay(1000);
    HAL_TIM_PWM_Start(&htim1, TIM_CHANNEL_1);
    HAL_TIM_PWM_Start(&htim1, TIM_CHANNEL_3);
    return pid_Init(values[0], values[1], values[2], 5, 100);
}

void do_pid(PID_t *pid_struct)
{
    /* Read sensors */
    uint8_t left = HAL_GPIO_ReadPin(TAPE_LEFT_GPIO_Port, TAPE_LEFT_Pin) ? 0 : 1;
    uint8_t right = HAL_GPIO_ReadPin(TAPE_RIGHT_GPIO_Port, TAPE_RIGHT_Pin) ? 0 : 1;

    /* Get error */
    if (left && right)
    {
        pid_struct->err = 0;
    }
    else if (left && !right)
    {
        pid_struct->err = 1;
    }
    else if (!left && right)
    {
        pid_struct->err = -1;
    }
    else if (!left && !right && (pid_struct->err < 0))
    {
        pid_struct->err = -5;
    }
    else if (!left && !right && (pid_struct->err > 0))
    {
        pid_struct->err = 5;
    }

    /* Get gain */
    int16_t gain = pid_GetGain(pid_struct);
    char msg[20] = "";
    sprintf(msg, "%d", (int)gain);
    print(msg, 0);
    /* Set Motor Speeds*/
    int lspeed = LEFT_SPEED;
    int rspeed = RIGHT_SPEED;
    if (gain < 0)
    {
        lspeed = LEFT_SPEED - gain;
    }
    else if (gain > 0)
    {
        rspeed = RIGHT_SPEED + gain;
    }
    __HAL_TIM_SET_COMPARE(&htim1, TIM_CHANNEL_1, lspeed);
    __HAL_TIM_SET_COMPARE(&htim1, TIM_CHANNEL_3, rspeed);
}

void set_motor_speed(uint32_t channel, uint32_t speed)
{
    if (channel == TIM_CHANNEL_1)
    {
        __HAL_TIM_SET_COMPARE(&htim1, TIM_CHANNEL_2, 0);
        __HAL_TIM_SET_COMPARE(&htim1, TIM_CHANNEL_1, speed);
    }
    else if (channel == TIM_CHANNEL_2)
    {
        __HAL_TIM_SET_COMPARE(&htim1, TIM_CHANNEL_1, 0);
        __HAL_TIM_SET_COMPARE(&htim1, TIM_CHANNEL_2, speed);
    }
    else if (channel == TIM_CHANNEL_3)
    {
        __HAL_TIM_SET_COMPARE(&htim1, TIM_CHANNEL_4, 0);
        __HAL_TIM_SET_COMPARE(&htim1, TIM_CHANNEL_3, speed);
    }
    else if (channel == TIM_CHANNEL_4)
    {
        __HAL_TIM_SET_COMPARE(&htim1, TIM_CHANNEL_3, 0);
        __HAL_TIM_SET_COMPARE(&htim1, TIM_CHANNEL_4, speed);
    }
}

void encoder_pid(PID_t *left_pid, ENCODER_t *left_enc, PID_t *right_pid, ENCODER_t *right_enc)
{
    /* Get error */
    float l_enc = update_encoder(left_enc);
    float r_enc = update_encoder(right_enc);
    left_pid->err = ENCODER_GOAL - l_enc;
    right_pid->err = ENCODER_GOAL - r_enc;

    /* Get gain */
    int32_t left_gain = pid_GetGain(left_pid);
    int32_t right_gain = pid_GetGain(right_pid);

    int l_predec = (int)(l_enc / 1);
    int l_postdec = (int)((l_enc - l_predec) * 1000);
    int r_predec = (int)(r_enc / 1);
    int r_postdec = (int)((r_enc - r_predec) * 1000);
    char msg[18] = "";
    sprintf(msg, "LG: %d.%d", l_predec, l_postdec);
    print(msg, 0);
    sprintf(msg, "RG: %d.%d", r_predec, r_postdec);
    print(msg, 1);

    /* Set Motor Speeds*/
    int lspeed = LEFT_SPEED + left_gain;
    int rspeed = RIGHT_SPEED + right_gain;

    sprintf(msg, "LS: %d", (int)lspeed);
    print(msg, 3);
    sprintf(msg, "RS: %d", (int)rspeed);
    print(msg, 4);
    // set_motor_speed
    set_motor_speed(TIM_CHANNEL_1, lspeed);
    set_motor_speed(TIM_CHANNEL_3, rspeed);
}

void encoder_dist_pid(PID_t *pid_obj)
{
    /* Get error */
    uint32_t l_enc = TIM3->CNT;
    uint32_t r_enc = TIM4->CNT;
    pid_obj->err = l_enc - r_enc;

    /* Get gain */
    int32_t gain = pid_GetGain(pid_obj);

    // Print
    int l_predec = (int)(l_enc / 1);
    int l_postdec = (int)((l_enc - l_predec) * 1000);
    int r_predec = (int)(r_enc / 1);
    int r_postdec = (int)((r_enc - r_predec) * 1000);
    char msg[18] = "";
    sprintf(msg, "LG: %d.%d", l_predec, l_postdec);
    print(msg, 0);
    sprintf(msg, "RG: %d.%d", r_predec, r_postdec);
    print(msg, 1);
    // Print

    /* Set Motor Speeds*/
    int lspeed = LEFT_SPEED - gain;
    int rspeed = RIGHT_SPEED + gain;

    // Print
    sprintf(msg, "err: %d", (int)pid_obj->err);
    print(msg, 3);
    sprintf(msg, "gain: %d", (int)gain);
    print(msg, 4);
    // Print

    // set_motor_speed
    set_motor_speed(TIM_CHANNEL_1, lspeed);
    set_motor_speed(TIM_CHANNEL_3, rspeed);

    // Reset CNTs for overflows
    TIM4->CNT = 0;
    TIM3->CNT = 0;
}

/* USER CODE END 4 */
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
