roeetal/enph253/Software/STM32/Brain/Brain.ioc

Mcu.UserName=STM32F401RETx
PA0-WKUP.GPIO_Label=ENCODER_RIGHT_1
PA0-WKUP.Signal=S_TIM5_CH1
PA1.GPIO_Label=ENCODER_RIGHT_2
PA1.Signal=S_TIM5_CH2
PA10.GPIO_Label=MOTOR_R_F
PA10.Signal=S_TIM1_CH3
PA11.GPIO_Label=MOTOR_R_B
PA11.Signal=S_TIM1_CH4
PA4.GPIO_Label=PI_ANALOG
PA4.Signal=ADCx_IN4
PA5.GPIO_Label=IR_1
PA5.Signal=ADCx_IN5
PA6.GPIO_Label=SERVO_CLAW_JAW
PA6.Signal=S_TIM3_CH1
PA7.GPIO_Label=SERVO_CLAW_ARM
PA7.Signal=S_TIM3_CH2
PA8.GPIO_Label=MOTOR_L_F
PA8.Signal=S_TIM1_CH1
PA9.GPIO_Label=MOTOR_L_B
PA9.Signal=S_TIM1_CH2
PB0.GPIO_Label=SERVO_BASKET
PB0.Signal=S_TIM3_CH3
PB1.GPIO_Label=ER
PB1.Signal=ADCx_IN9
PB14.GPIO_Label=TAPE_LEFT
PB14.Signal=GPXTI14
PB15.GPIO_Label=TAPE_RIGHT
PB15.Signal=GPXTI15
PB4.GPIO_Label=CLAW_INT
PB4.Signal=GPXTI4
PB6.GPIO_Label=ENCODER_LEFT_1
PB6.Signal=S_TIM4_CH1
PB7.GPIO_Label=ENCODER_LEFT_2
PB7.Signal=S_TIM4_CH2
PB8.Signal=I2C1_SCL
PB9.Signal=I2C1_SDA
PC0.GPIO_Label=PI_INT
PC0.Signal=GPXTI0
PC1.GPIO_Label=IR_INT
PC1.Signal=GPXTI1
PC13-ANTI_TAMP.GPIO_Label=MENU
PC13-ANTI_TAMP.Signal=GPIO_Input
PC2.GPIO_Label=TL
PC2.Signal=ADCx_IN12
PC3.GPIO_Label=EDGE_RIGHT
PC3.Signal=GPXTI3
PC4.GPIO_Label=TR
PC4.Signal=ADCx_IN14
PC5.GPIO_Label=EL
PC5.Signal=ADCx_IN15
PC6.GPIO_Label=STM_TX
PC6.Signal=USART6_TX
PC7.GPIO_Label=STM_RX
PC7.Signal=USART6_RX
PD2.GPIO_Label=EDGE_LEFT
PD2.Signal=GPXTI2
