roeetal/enph253/Software/STM32/brain/Inc/encoder.h

#include"stm32f4xx_hal.h"

#ifndef encoder

#define encoder 

#define ENCODER_N 100
#define ENCODER_R 1000

typedef struct{
    uint16_t cnt;
    uint16_t time;
    float speed;
    TIM_TypeDef *tim;
} ENCODER_t;

ENCODER_t encoder_Init(TIM_TypeDef *tim);
float update_encoder(ENCODER_t *enc);

#endif
