roeetal/enph253/(commit log)

2018-06-16 tape follow update with PID
2018-06-22 Presentation (#2)
    * pressy start
    * Update pressy.md
    Made some suggestions, what you guys think. I think its a more fluid, understandable approach to presenting.
    * Added block diagram
    * Delete Untitled Diagram.png
    * Block Diagrams
    * Update Block Diagram.xml
    * Update pressy.md
    * Update pressy.md
    * update block diagram
    * Delete old block diag
    - view new diagram xml files on draw.io
    * block diagram update
    * another one
    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
2018-06-22 oled example
    [untitled.brd, untitled.sch]
2018-06-22 Edges (#4)
    * matlab edge detection start
    * updates
    * stm32
    * make stizzle
2018-06-22 Added calculations spreadsheet
    [design_calculations.xlsx]
2018-06-23 Added PID library
2018-06-23 add ADC pin
2018-06-24 Implemented PID; Derivative term needs work
2018-06-29 continuous ADC Sampling complete
2018-06-30 ir square wave schematic
2018-06-30 Revert "regulator"
    This reverts commit 0ff39721ac493a19ae8de3e9ca2d5f687df9d53b.
2018-07-02 readme encoder
2018-07-03 pwm works, same duty cycle though
2018-07-03 test pwm
2018-07-04 Sonar Working
2018-07-04 Update Sonar Jazz
2018-07-04 add little readme, lower ADC bits
2018-07-05 Servo done
2018-07-05 ir sensor code works and module tuned
2018-07-09 started pcb
    [board.brd, board.sch, tape_follower.sch, untitled.brd, untitled.sch]
2018-07-09 circuit updates
    [board.brd, board.sch]
2018-07-09 hbridge pcb done
2018-07-09 almost there
    [board.brd, board.sch]
2018-07-09 finalized circuit
    [board.brd, board.sch]
2018-07-11 menu with encoder, push and motor control
2018-07-13 motor control
2018-07-13 tape following and some encoder
2018-07-14 tape follower init motor speed
2018-07-17 encoders done
2018-07-17 encoder finished
2018-07-17 encoder done
2018-07-17 adc dma works
2018-07-19 servo basket integration
2018-07-19 updated cube, pcb
    [board.brd, board.sch]
2018-07-19 servo done - make libraries pretty
2018-07-25 import claw.h shes done boys
2018-07-25 encoder, button, screen works on blue pill
2018-07-26 claw interrupt
2018-07-31 testing encoder pid
2018-07-31 turning fixed i think,
    [main.c, main.h, pid.c, pid.h]
2018-08-10 claw working
2018-08-10 encoder pid
2018-08-10 create tests and create project to reset PWM pins
    [ResetPWMPins.ioc, main.c, main.h]
2018-08-10 Removed interrupts. Navigates to 1st ewok
2018-08-10 Side hoe (#26)
    * update f4 cube
    * ported over to f4
    * continued
    * alarm working
    * edge detection works
    * f
    * claw working
    * edge, tape done
    * everything works
    * mas
    * merged
    * save
    * some updates
    * some updates
    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
